mgit09/sistema-bebedouro/hardware/placa-alimentacao/layout_pcb_alimentacao.jpeg

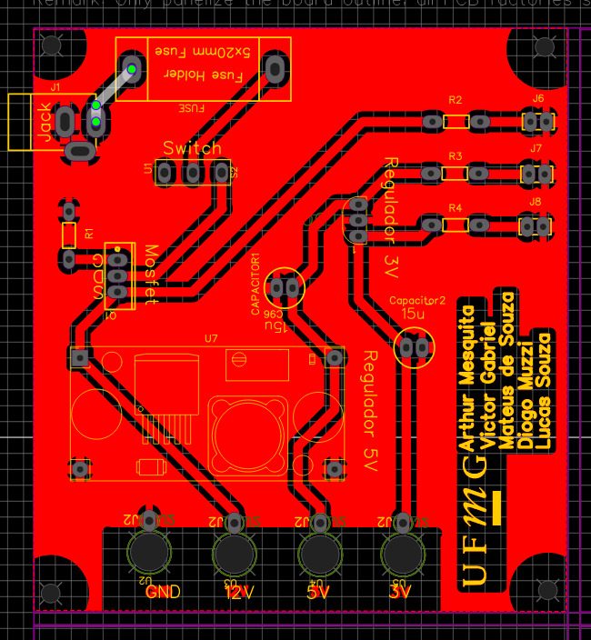
hardware/placa-alimentacao/layout_pcb_alimentacao.jpeg
