mgit09/sistema-bebedouro/hardware/placa-alimentacao/esquematico_pcb_alimentacao.jpeg

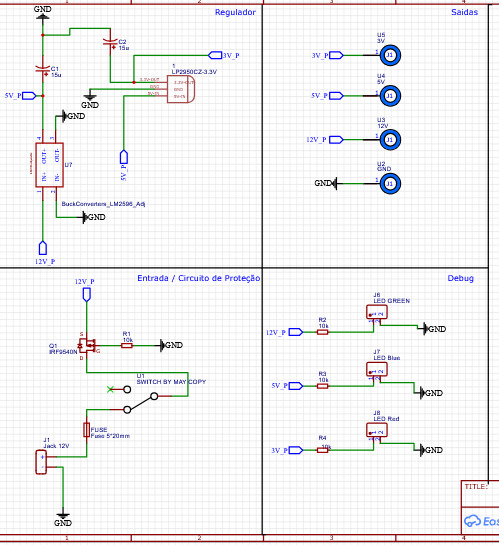
hardware/placa-alimentacao/esquematico_pcb_alimentacao.jpeg
