mgit09/sistema-bebedouro/hardware/placa-principal/esquematico-2_pcb_principal.jpeg

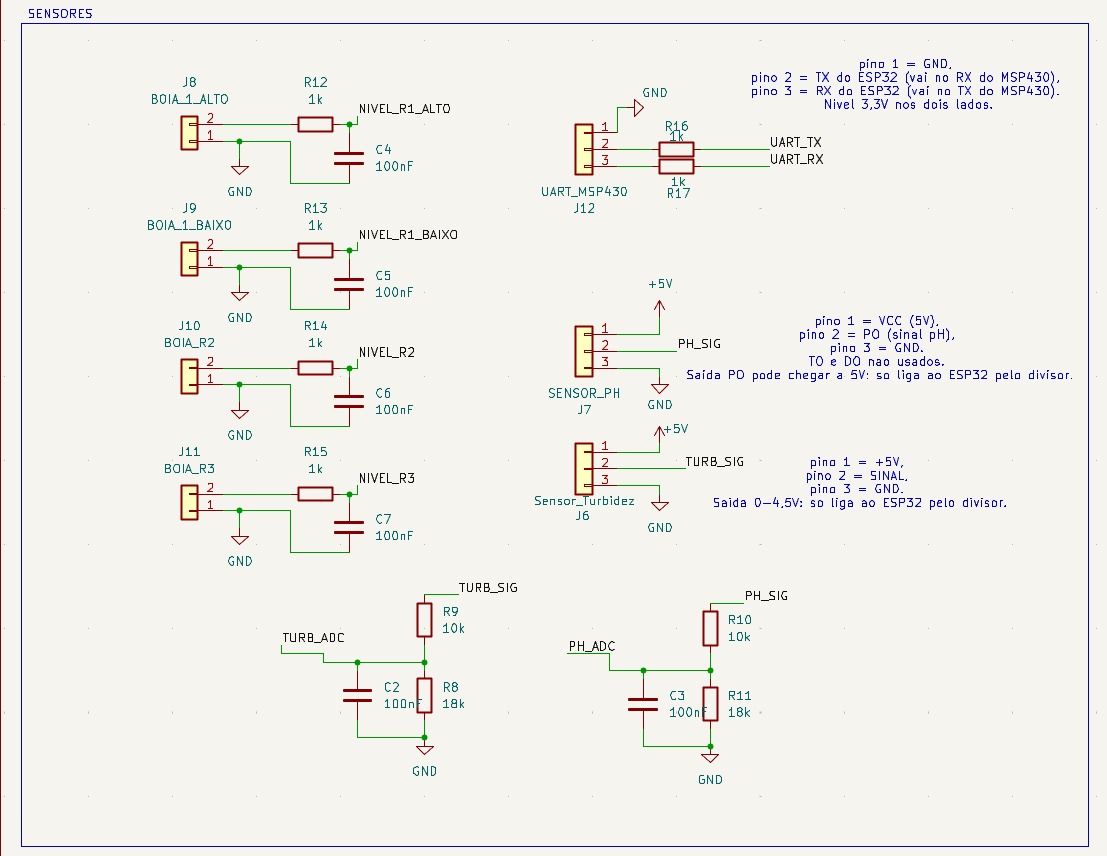
hardware/placa-principal/esquematico-2_pcb_principal.jpeg
