mgit09/sistema-bebedouro/hardware/placa-principal/esquematico-3_pcb_principal.jpeg

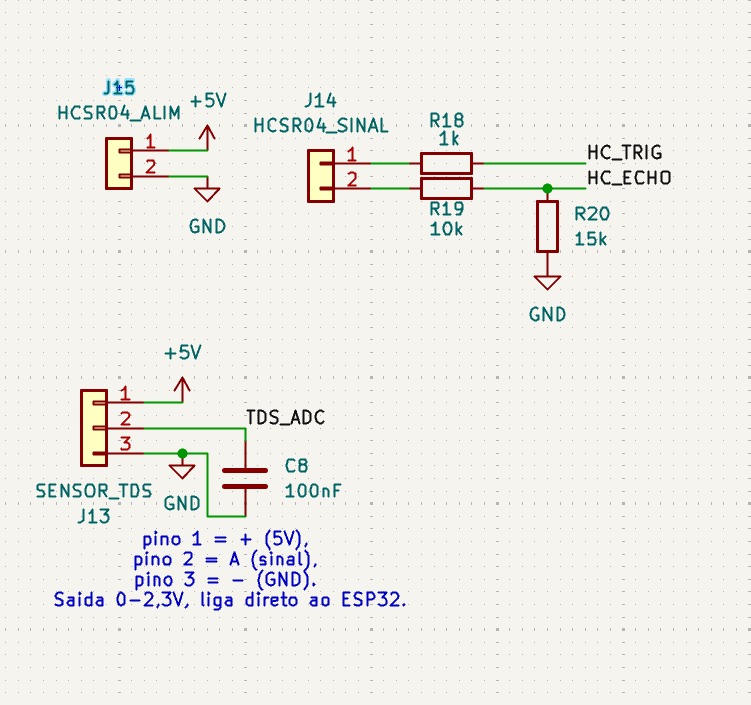
hardware/placa-principal/esquematico-3_pcb_principal.jpeg
