mgit09/sistema-bebedouro/hardware/placa-principal/esquematico-4_pcb_principal.jpeg

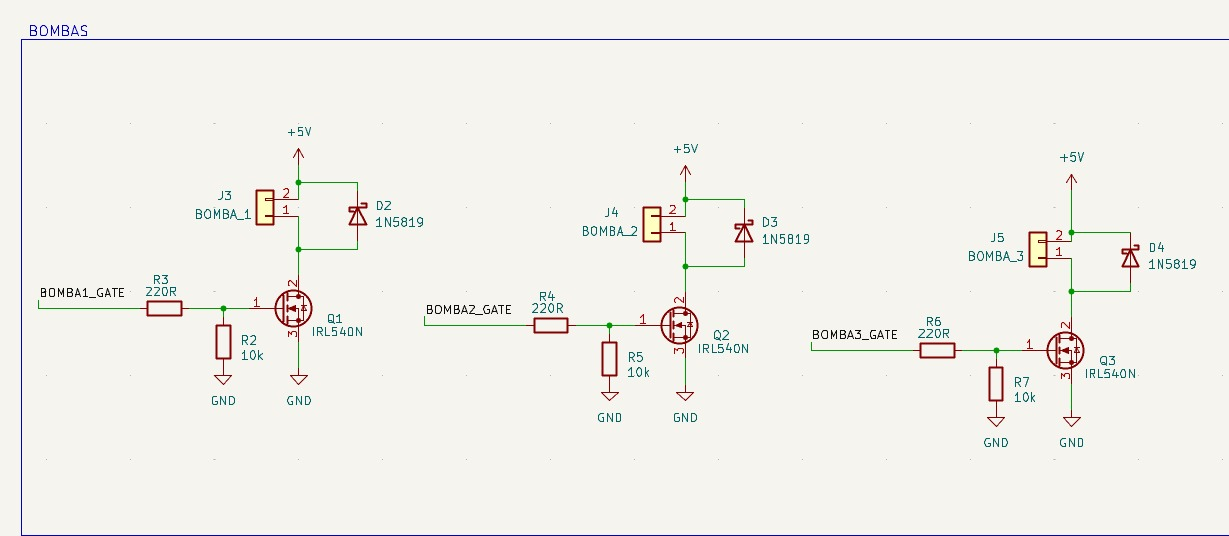
hardware/placa-principal/esquematico-4_pcb_principal.jpeg
