mgit09/sistema-bebedouro/hardware/placa-principal/esquematico-5_pcb_principal.jpeg

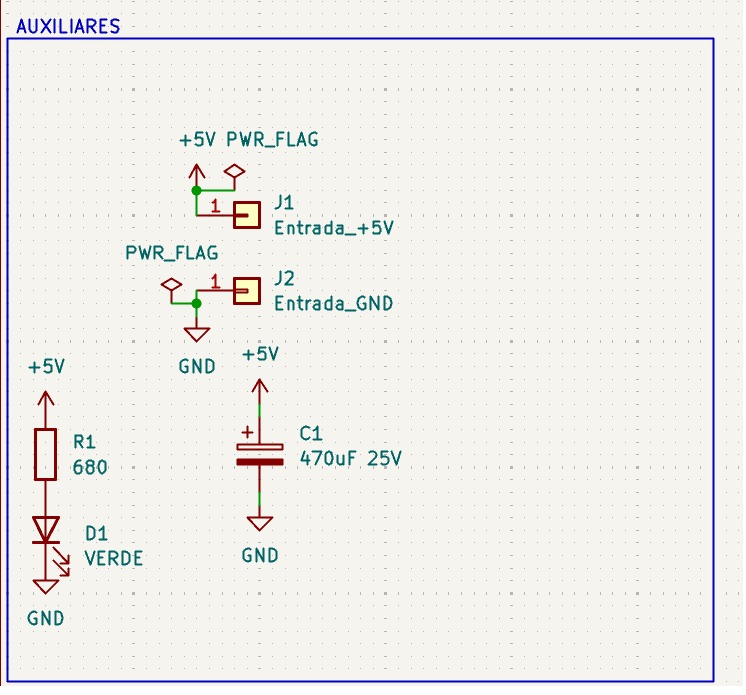
hardware/placa-principal/esquematico-5_pcb_principal.jpeg
