mgit09/sistema-bebedouro/docs/logica_esp.ods

Sheet: Nome dos componentes
COMPONENTE | CÓDIGO
Recipiente de água limpa, que atua como reservatório do bebedouro | r1
Recipiente de água suja, que atua como destino e reservatório da água de descarte do bebedouro | r2
Bebedouro onde o gato efetivamente bebe água | bebedouro
Bomba de água do r1 que manda água limpa pro bebedouro | bomba1
Bomba de água do bebedouro que manda água suja pra r2 | bomba2
Bomba de água do bebedouro que fica circulando a água | bomba3
Sensor de nível de água do r1 | snivel1
Sensor de nível de água do r2 | snivel2
Sensor de nível máximo de água do bebedouro | snivel3max
Sensor de nível mínimo de água do bebedouro | snivel3min
LED vermelho de aviso para repor água do r1 | led1
LED vermelho de aviso para remover água do r2 | led2
LED amarelo de aviso que o processo de troca de água do bebedouro pendente/em andamento | led3
Sensor de presença para detectar presença do gato em frente ao bebedouro | sprox
Sensor de TDS que fica na parte de baixo do bebedouro | stds
Sensor de turbidez que fica na parte de baixo do bebedouro | sturbidez
Sensor de PH que fica no bebedouro | sph

Sheet: Variável ESTADO_TROCA
VARIÁVEL “ESTADO_TROCA” | EXPLICAÇÃO
NORMAL | Não há troca de água solicitada.
AGUARDANDO | A água foi considerada ruim, mas o descarte ainda não começou.
DESCARTANDO | A bomba2 está retirando água do bebedouro.
REABASTECENDO | O descarte terminou e a bomba1 está repondo água limpa.

Sheet: Condições lógicas
ITEM | O QUÊ? | ONDE? | CONDIÇÃO (SE) | AÇÕES(ENTÃO) | PARE/MUDE QUANDO | COMENTÁRIOS
C1 | Alertar nível baixo em r1 | r1 | [Água r1 <= snivel1] | - Ligar o led1 | [Água r1 > snivel1] | O bloqueio da bomba é feito pela checagem nas condições que requerem a ativação dessa bomba
C2 | Alertar nível alto em r2 | r2 | [Água r2 >= snivel2] | - Ligar o led2 | [Água r2 < snivel2] | -
C3 | Registrar qualidade de água ruim e necessidade de troca | bebedouro | [ESTADO_TROCA = “NORMAL”] & ( [Água TDS > 120] OU [Água turbidez > 200] ) & [Água bebedouro > snivel3min] | - Definir ESTADO_TROCA = “AGUARDANDO” - Ligar led3 | - | Dessa forma, o sistema irá registrar uma troca pendente quando for detectado em qualquer momento uma qualidade ruim. A troca ocorrerá quando houverem condições adequadas. Além disso, a leitura dos sensores não conta se a água tiver no min (ou seja, se eles não tiverem submersos)
C4 | Mandar água de r1 pro bebedouro quando preciso | r1, bebedouro | { ( [ESTADO_TROCA = “NORMAL”] & [Água bebedouro <= snivel3min] ) OU ( [ESTADO_TROCA = “REABASTECENDO”] & [Água bebedouro < snivel3max] ) } & [Água r1 > snivel1] & [bomba2 = OFF] & [bomba3 = OFF] & [FALHA = False] | - Ligar a bomba1 | [Água bebedouro >= snivel3max] OU [Água r1 <= snivel1] | A condição também considera um reabastecimento no estado NORMAL, para o caso de ter evaporado água ou algo do tipo
C5 | Circular água no bebedouro | bebedouro | [ESTADO_TROCA = “NORMAL”] & [Água bebedouro > snivel3min] & [Água bebedouro <= snivel3max ] & [sprox = 1 por 5s ou mais] & [bomba1 = OFF] & [bomba2 = OFF] & [FALHA = False] | - Ligar a bomba3 | [sprox = 0 por pelo menos 5 s] OU [Água bebedouro <= snivel3min] | Aqui não há condições que verificam a condição da água (sinais opostos às condições de C6) pois somente depois do gato sair (terminar de beber) a condição C6 seria permitida. Além disso, a circulação para se por algum motivo anormal a água cair abaixo do min
C6 | Mandar água suja do bebedouro pra r2 (estado de descarte) | r2, bebedouro | ( [ESTADO_TROCA = “AGUARDANDO”] OU [ESTADO_TROCA = “DESCARTANDO”] ) & [Água bebedouro > snivel3min] & [Água r2 < snivel2] & [sprox = 0 por 6s ou mais] & [bomba1 = OFF] & [bomba3 = OFF] & [FALHA = False] | - Ligar a bomba2 - Definir ESTADO_TROCA = “DESCARTANDO” | [Água r2 >= snivel2] OU [Água bebedouro <= snivel3min] | Se r2 encher no meio do descarte, a bomba2 para. Por isso, a condição considera os dois estados, então o descarte retoma sozinho quando r2 for esvaziado
C7 | Finalizar descarte de água suja e trocar estado para reabastecendo | sistema | ( [ESTADO_TROCA = “DESCARTANDO”] OU [ESTADO_TROCA = “AGUARDANDO”] ) & [Água bebedouro <= snivel3min] | - Definir ESTADO_TROCA = “REABASTECENDO” | - | As condições consideram, além do DESCARTANDO, o AGUARDANDO também, pois se a água do bebedouro cair pro min antes de iniciar o descarte o sistema travaria (já que C6 considera [Água bebedouro > snivel3min])
C8 | Finalizar reabastecimento de água limpa e voltar ao funcionamento normal | sistema | [ESTADO_TROCA = "REABASTECENDO"] & [Água bebedouro >= snivel3max] | - Definir ESTADO_TROCA = "NORMAL", Desligar o led3 | - | -
C9 | Proteger contra bomba ligada por tempo demais | sistema | [bomba1 = ON continuamente por mais que T1] OU [bomba2 = ON continuamente por mais que T2] OU [bomba3 = ON continuamente por mais que T3] | - Piscar led1 e led2 enquanto FALHA = True - Desligar bomba1 - Desligar bomba2 - Desligar bomba3 - FALHA = True | - | Para sair da falha, o reinício do ESP já basta, porque a variável fica na memória e volta a falso ao ligar. Não precisa de botão.
