mgit09/sistema-bebedouro/(commit log)

2026-11-11 Adiciona arquivos de contextualização
    [logica_esp.ods]
2026-11-11 Adiciona códigos de teste do esp
2026-11-11 Cria arquivos para teste de página web com o esp
2026-11-11 Adiciona imagens dos esquemáticos das PCBs
2026-11-11 Adiciona teste das bombas de água
